leonardofhenrique/lfh-controllers/case/fader4/export/camadas.png

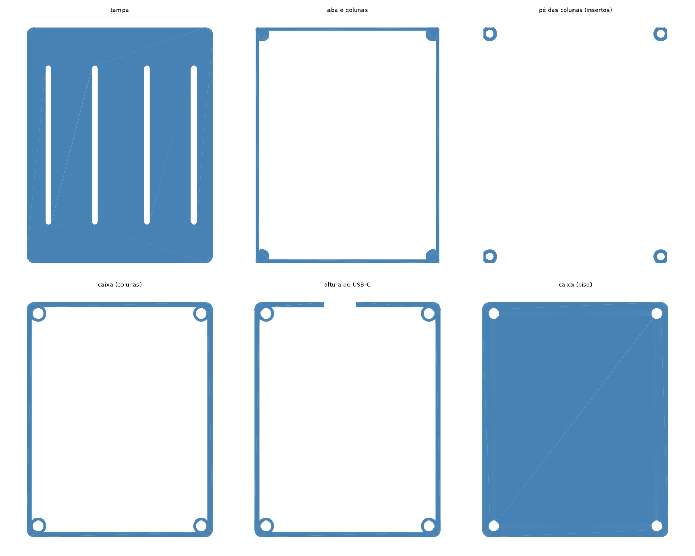
case/fader4/export/camadas.png
