leonardofhenrique/lfh-controllers/docs/deck/esquematico.png

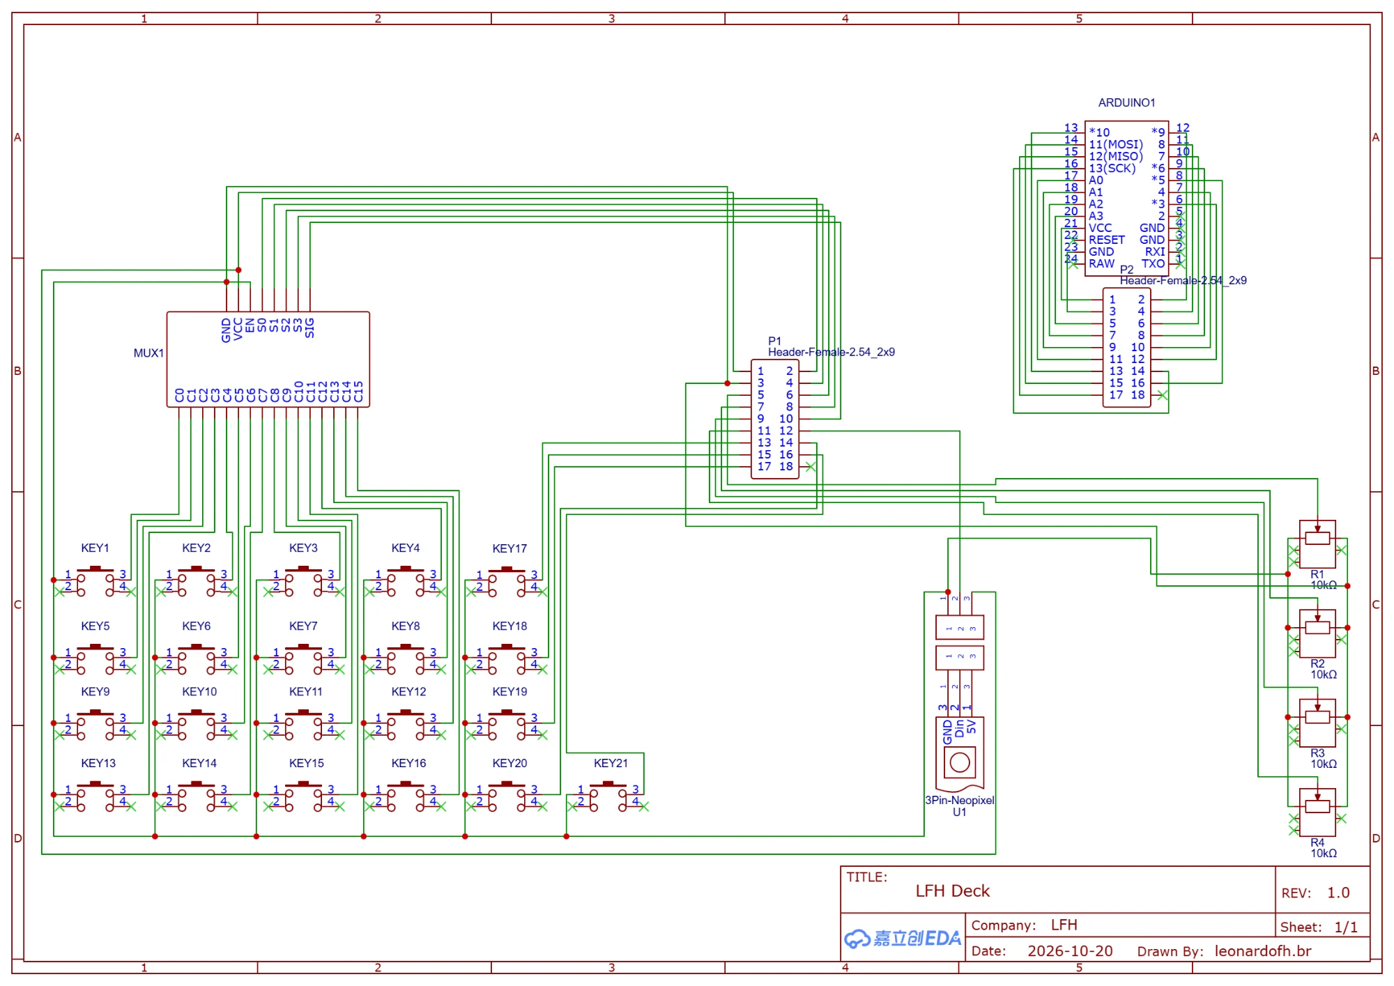
docs/deck/esquematico.png
