leonardofhenrique/lfh-controllers/docs/deck/placa-arduino.png

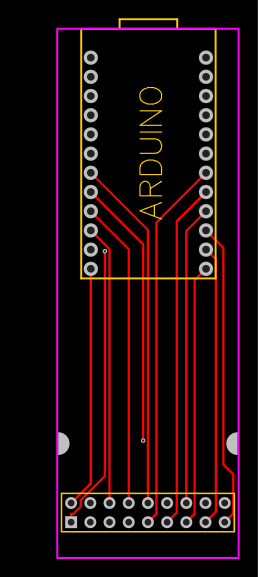
docs/deck/placa-arduino.png
