leonardofhenrique/lfh-controllers/docs/deck/placa-principal.png

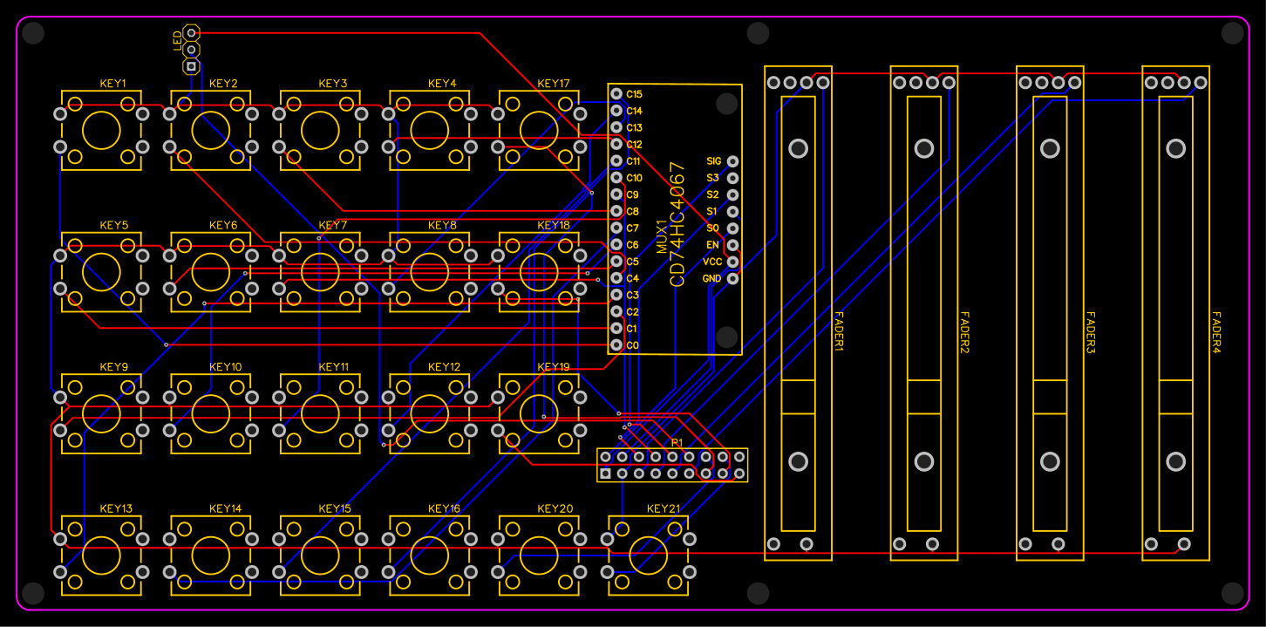
docs/deck/placa-principal.png
