leonardofhenrique/lfh-controllers/case/fader4/export/lfh_fader4_assembly.step

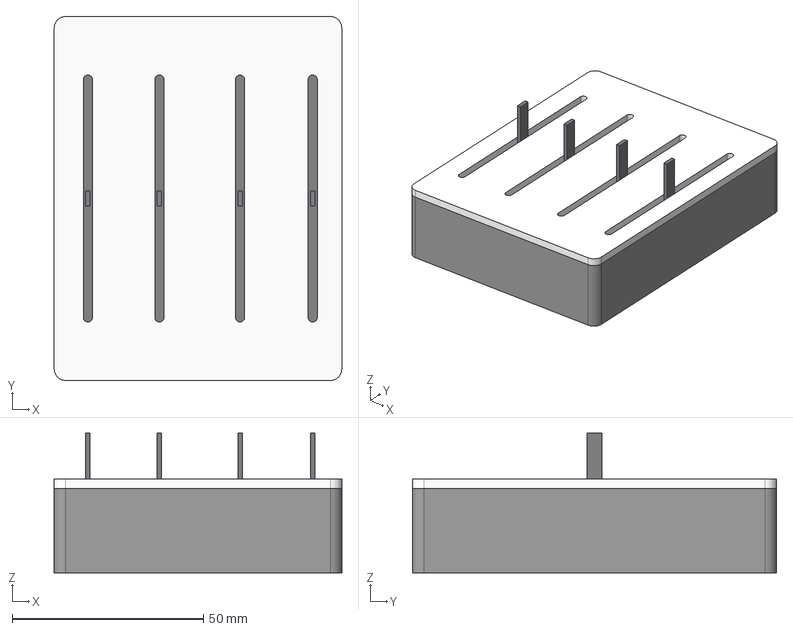
[picture p5: CAD file, 2026-10-17]
case/fader4/export/lfh_fader4_assembly.step
75.2 x 95.2 x 36.6 mm
bottom
plate
placa (referencia)
faders (referencia)
pro micro (referencia)
