leonardofhenrique/lfh-controllers/case/fader4/export/lfh_fader4_bottom.step

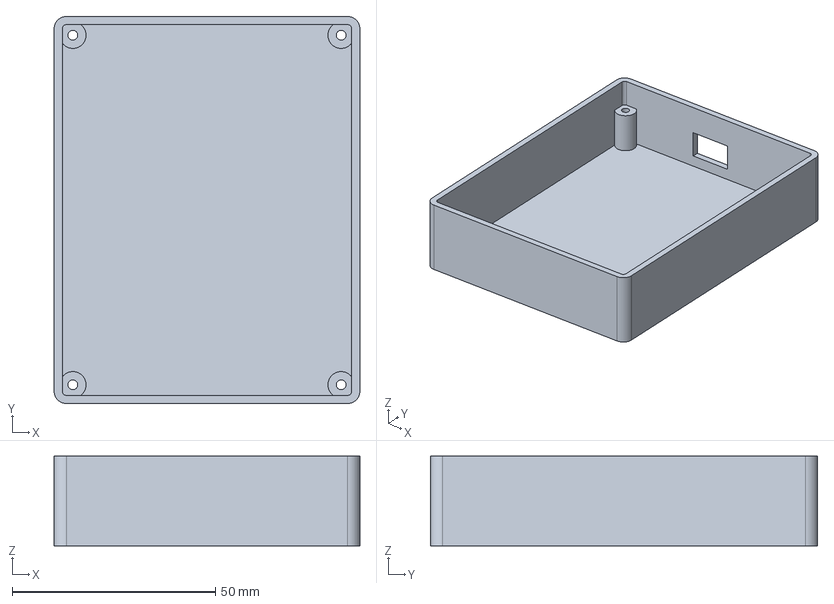
[picture p6: CAD file, 2026-10-17]
case/fader4/export/lfh_fader4_bottom.step
75.2 x 95.2 x 22.1 mm
