leonardofhenrique/lfh-controllers/case/fader4/export/lfh_fader4_plate.step

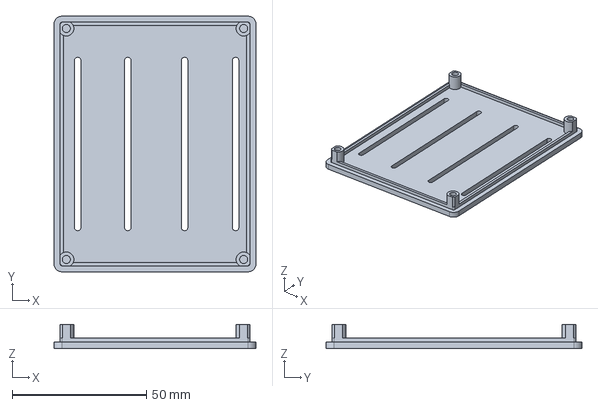
[picture p7: CAD file, 2026-10-17]
case/fader4/export/lfh_fader4_plate.step
75.2 x 95.2 x 9.00 mm
