leonardofhenrique/lfh-controllers/case/fader4/export/lfh_fader4_test_stencil.step

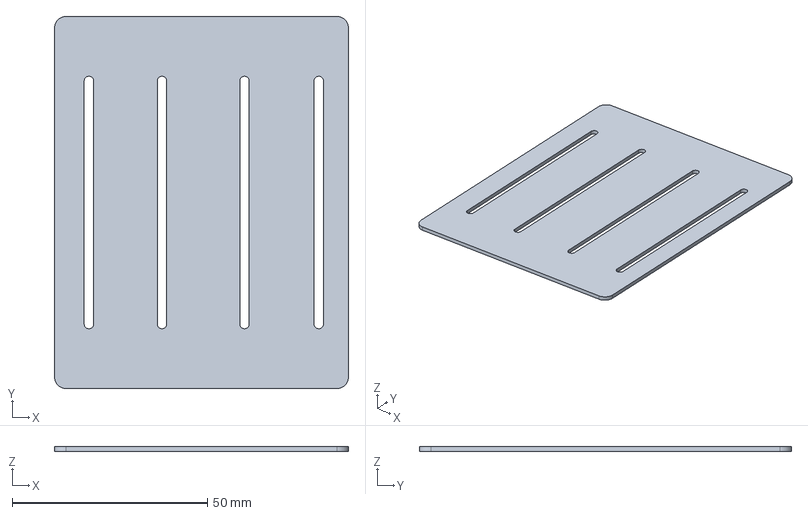
[picture p8: CAD file, 2026-10-17]
case/fader4/export/lfh_fader4_test_stencil.step
75.2 x 95.2 x 1.20 mm
