leonardofhenrique/lfh-controllers/(list of files, cad)

Other CAD files:
case/fader4/export/lfh_fader4_bottom.stl
case/fader4/export/lfh_fader4_plate.stl
case/fader4/export/lfh_fader4_test_stencil.stl
