leonardofhenrique/lfh-controllers/(commit log)

2026-10-16 LFH Fader 4 v2.0.0: 4 faders fixos, inverter, apelidos, mesa visual e identificacao de entradas
2026-10-16 Configurador: 4 quadrados de entrada, tocar e tocar, canal unico no topo e porcentagem
2026-10-16 Adiciona lista de ideias para o futuro
2026-10-16 Roadmap: modelos de controlador, gravacao de firmware e versao desktop
2026-10-17 Case impressa: tampa com rasgos dos faders e caixa com Pro Micro
    Modelo CadQuery (case/lfh_fader4_case.py) com STEP/STL exportados e peça de teste
    de um fader. Distância entre os furos M2 do fader (70 mm) ainda precisa ser medida.
    [lfh_fader4_assembly.step, lfh_fader4_bottom.step, lfh_fader4_bottom.stl, lfh_fader4_plate.step, lfh_fader4_plate.stl, lfh_fader4_test_plate.step, lfh_fader4_test_plate.stl]
2026-10-17 Case: redesenhada para a placa perfurada 70x90 com Pro Micro embaixo
    Caixa do tamanho da placa (75 x 95 x 24,6 mm). Placa presa entre colunas da caixa e
    da tampa por 4 parafusos M2 x 8 por baixo. Posições dos faders, furos dos cantos e
    USB-C estimadas por foto; gabarito fino (test_stencil) para conferir os rasgos.
    [lfh_fader4_assembly.step, lfh_fader4_bottom.step, lfh_fader4_bottom.stl, lfh_fader4_plate.step, lfh_fader4_plate.stl, lfh_fader4_test_plate.step, lfh_fader4_test_plate.stl, lfh_fader4_test_stencil.step]
2026-10-19 Reorganiza o repositório para vários controladores
    - Código comum (transporte SysEx e leitura dos faders) vira a biblioteca
    libraries/LFHCore, para o Fader 4 e o Deck usarem o mesmo código.
    - Firmware do Fader 4 passa para firmware/LFH_Fader_4 e usa a LFHCore.
    O formato da EEPROM e o protocolo continuam iguais (firmware v2).
    - Case do Fader 4 vai para case/fader4.
    [lfh_fader4_assembly.step, lfh_fader4_bottom.step, lfh_fader4_bottom.stl, lfh_fader4_plate.step, lfh_fader4_plate.stl, lfh_fader4_test_stencil.step, lfh_fader4_test_stencil.stl]
2026-10-19 Firmware do LFH Deck v1 e placas LFH Deck
    4 faders iguais aos do Fader 4, botões 1-16 pelo CD74HC4067 e 17-21 direto
    no Arduino, 21 LEDs WS2812. Três camadas, cada uma com canal MIDI e cor; o
    botão 21 troca a camada e o LED dele mostra a cor. Nomes dos botões por
    camada gravados na EEPROM. Dispositivo SysEx 44 ('D'), comandos 10-13 para
    os nomes e a camada atual.
2026-10-19 Configurador v2.2: reconhece o modelo e ganha a tela do LFH Deck
    A página pergunta com o byte de cada modelo e mostra a tela certa. No Deck:
    abas das camadas com canal e cor, botões na posição do painel com nome,
    brilho dos LEDs e botões acendendo na tela quando apertados. A tela do
    Fader 4 não muda.
2026-10-19 Documentação para o Fader 4 e o Deck
    README e CLAUDE.md com a estrutura nova, o protocolo do Deck e as tags com
    o modelo na frente; desenho do painel e das ligações do Deck em docs/;
    roadmap atualizado.
2026-10-19 Deck: debounce dos botões de 10 para 30 ms
    No teste na placa, alguns botões mandavam 2 ou 3 notas por toque.
2026-10-19 Deck: LEDs dos botões controlados pelo computador
    Apertar o botão não muda mais o LED. O computador manda Note On no canal da
    camada, com a nota = número do botão e a velocity = cor da paleta (0-9, a
    mesma do arduino_midi_v5); Note Off ou velocity fora da paleta apaga. Cada
    camada guarda as próprias cores. Nota 127 apaga todos os LEDs sem esquecer
    as cores e a nota 126 religa.
2026-10-19 Deck: ordem dos LEDs confirmada na placa
2026-10-19 Configurador: escolher o controlador quando houver mais de um ligado
    A busca agora encontra todos os controladores LFH conectados. Com um só,
    conecta direto como antes; com dois ou mais, mostra um cartão para escolher
    e uma lista no topo para trocar depois. Ao trocar, desliga o modo
    identificar do anterior e avisa se há alterações não salvas.
2026-10-19 Deck: botões numerados pela posição no painel; nota 127 não apaga o LED 21
    - Botões passam a ser numerados linha por linha (1-5, 6-10, 11-15, 16-20 e
    21), então botão N = nota N = LED N. A tabela KEY_INPUT diz de onde vem cada
    botão (canal do multiplexador ou pino direto); LED_OF fica para quando a
    fiação dos LEDs mudar na montagem.
    - Nota 127 apaga só os LEDs 1-20; o 21 continua mostrando a camada.
    - Configurador, desenho do painel e documentação com a numeração nova.
2026-10-19 Configurador: tela inicial para conectar e escolher o controlador
    A página abre numa tela inicial, sem mostrar nenhum modelo, com o botão de
    conectar. Os controladores encontrados aparecem nela como botões, e cada um
    leva para a tela do modelo. "Trocar controlador" volta para a tela inicial,
    e a tela inicial também abre um arquivo exportado quando não há controlador.
2026-10-27 Logo LFH: letras feitas de trilhos e cursores de fader
    docs/logo com versões para fundo claro e escuro e ícone. README mostra o logo
    (troca com o tema do GitHub); configurador ganha o logo na tela inicial e no
    cabeçalho, e o ícone na aba do navegador.
2026-10-27 Logo: ícone .ico (16 a 256 px) e PNG de 256 px
    Para usar em atalhos do Windows (o .html não aceita ícone próprio).
